jmmarino2/spinnaker/img/spinnaker_block_diagram.png

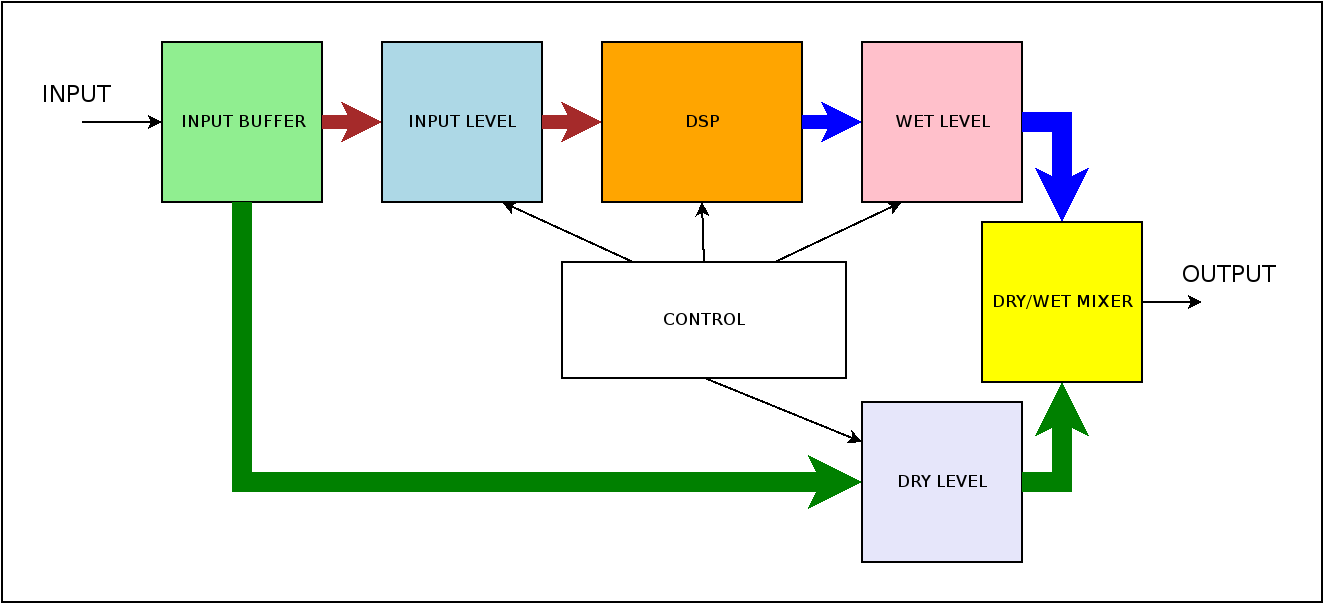
img/spinnaker_block_diagram.png
