jmmarino2/spinnaker/schematics/spinnaker_kicad/spinnaker.kicad_pcb

## KiCad design schematics/spinnaker_kicad/spinnaker.kicad_pcb (2025-03-15)

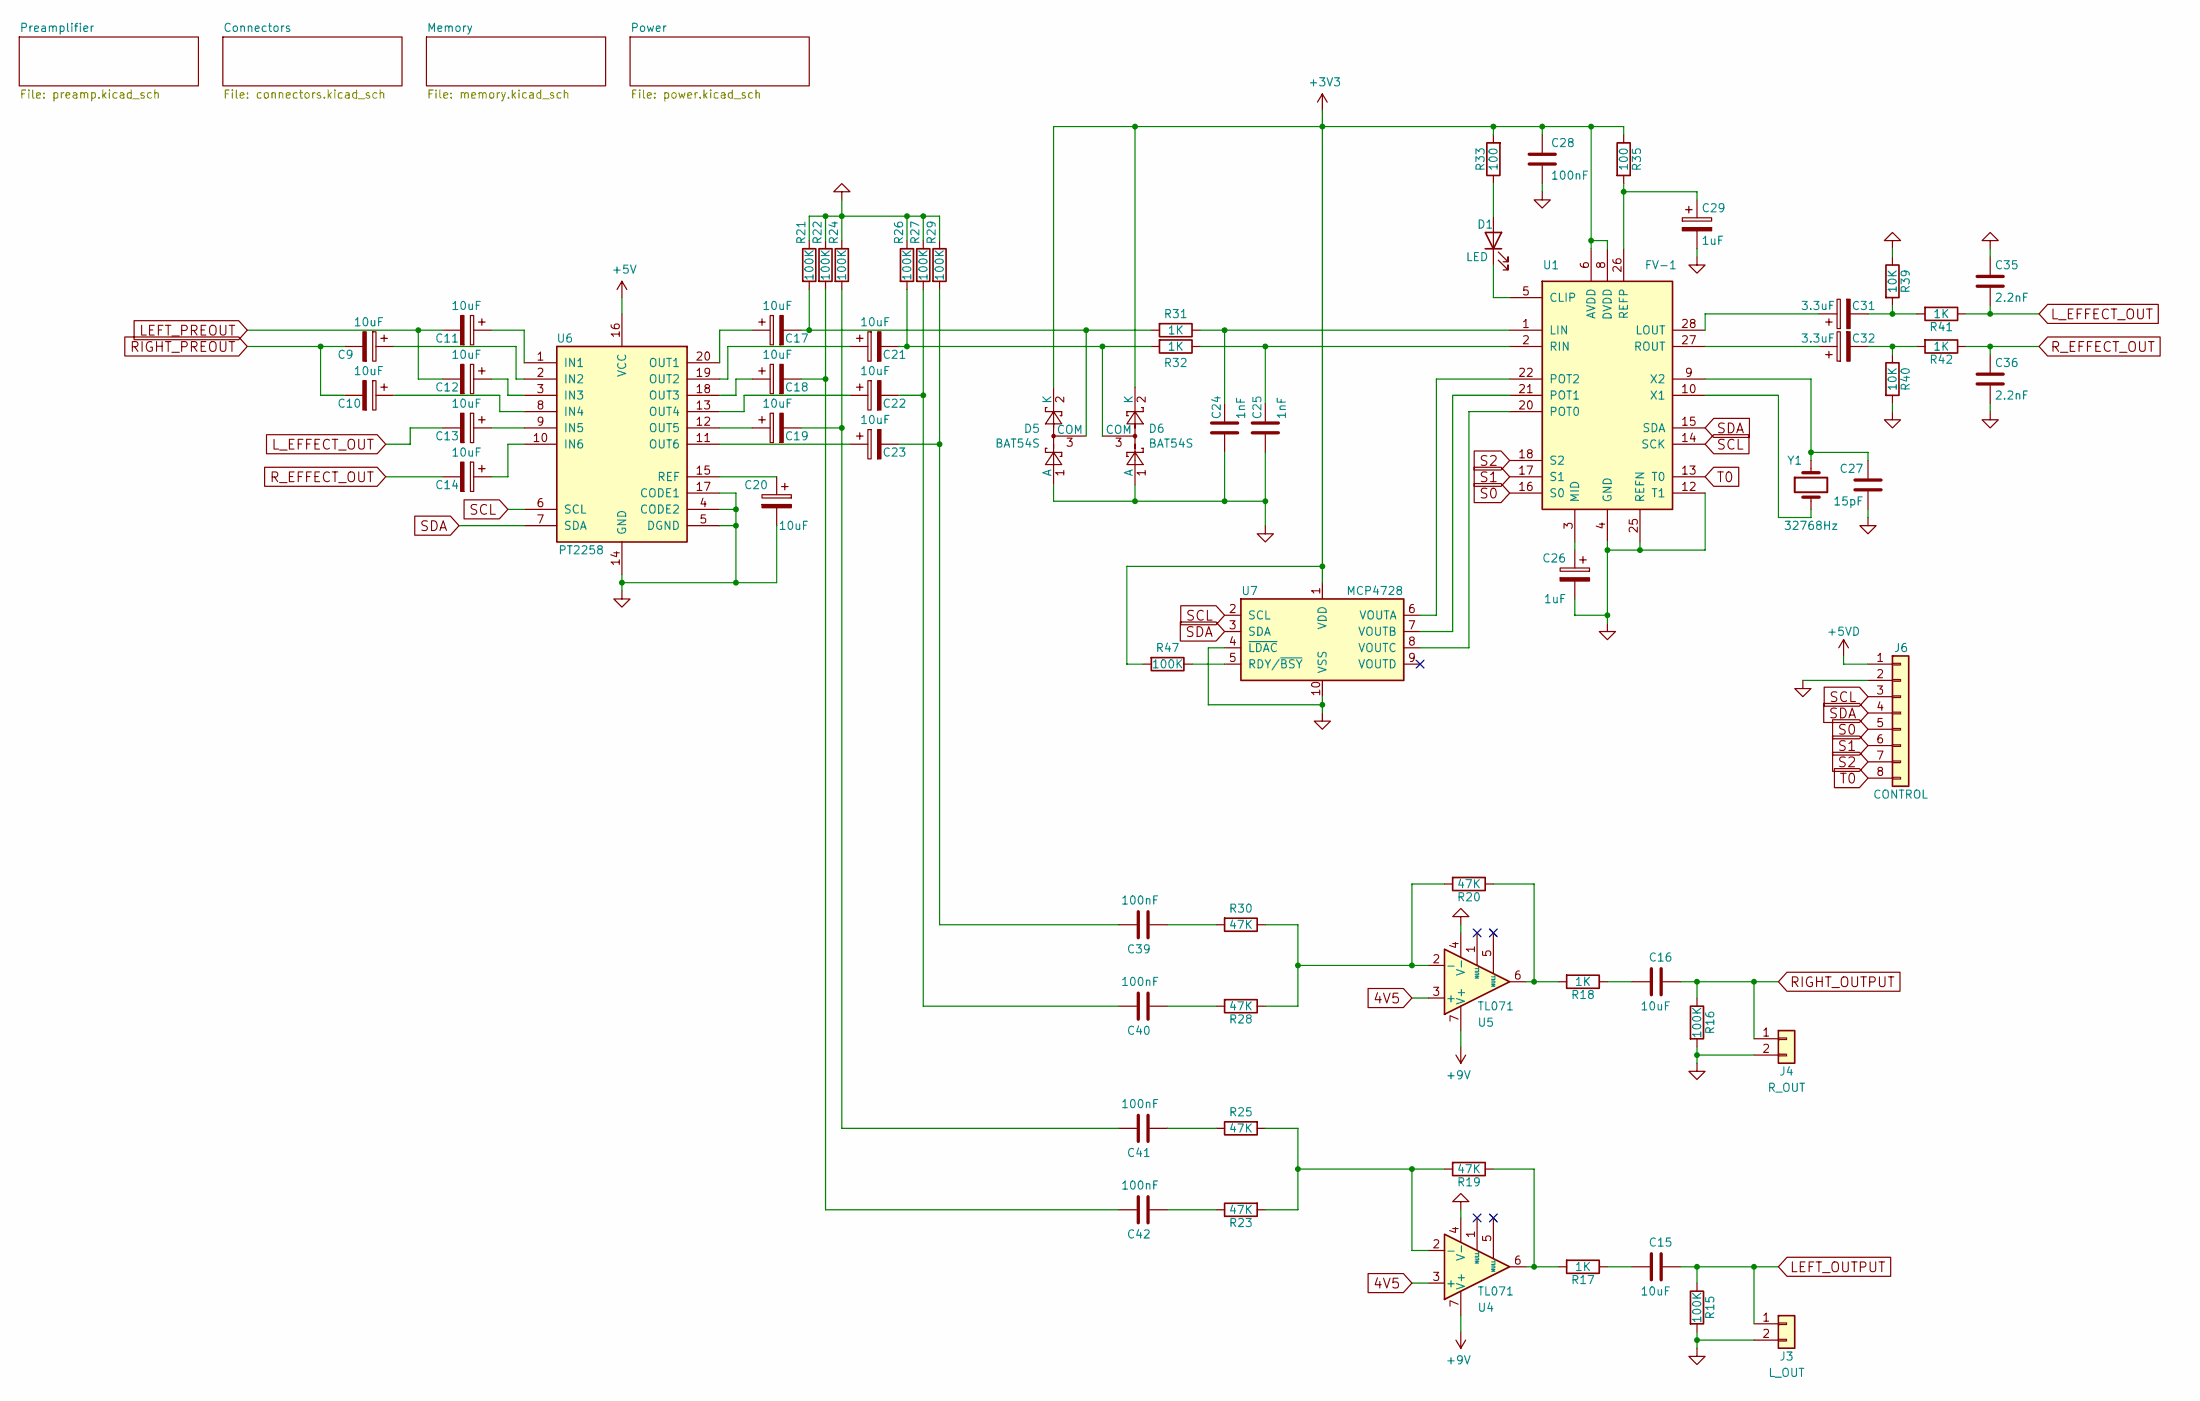
[picture p2: schematic spinnaker.kicad_sch]

Parts:
C9, C10, C11, C12, C13, C14, C15, C16, C17, C18, C19, C20, C21, C22, C23: 10uF; C_0805_2012Metric
C24, C25: 1nF; C_0805_2012Metric
C26, C29: 1uF; C_0805_2012Metric
C27: 15pF; C_0805_2012Metric
C28, C39, C40, C41, C42: 100nF; C_0805_2012Metric
C31, C32: 3.3uF; C_0805_2012Metric
C35, C36: 2.2nF; C_0805_2012Metric
D1: LED; SolderWire-0.75sqmm_1x02_P4.8mm_D1.25mm_OD2.3mm
D5, D6: BAT54S; SOT-23
J3: L_OUT; SolderWire-0.75sqmm_1x02_P4.8mm_D1.25mm_OD2.3mm
J4: R_OUT; SolderWire-0.75sqmm_1x02_P4.8mm_D1.25mm_OD2.3mm
J6: CONTROL; JST_PH_B8B-PH-K_1x08_P2.00mm_Vertical
R15, R16, R21, R22, R24, R26, R27, R29, R47: 100K; R_0805_2012Metric
R17, R18, R31, R32, R41, R42: 1K; R_0805_2012Metric
R19, R20, R23, R25, R28, R30: 47K; R_0805_2012Metric
R33, R35: 100; R_0805_2012Metric
R39, R40: 10K; R_0805_2012Metric
U1: FV-1; SOIC-28W_7.5x17.9mm_P1.27mm
U4, U5: TL071; SOIC-8_3.9x4.9mm_P1.27mm
U6: PT2258; SO-20_12.8x7.5mm_P1.27mm
U7: MCP4728; MSOP-10_3x3mm_P0.5mm
Y1: 32768Hz; Crystal_SMD_3215-2Pin_3.2x1.5mm

Connections:
4V5: U4.3 (+), U5.3 (+); also elsewhere on the board
+5V: U6.16 (VCC); also elsewhere on the board
+5VD: J6.1; also elsewhere on the board
+9V: U4.7 (V+), U5.7 (V+); also elsewhere on the board
Earth: C20.2, C24.2, C25.2, C26.2, C27.2, C28.1, C29.2, C35.1, C36.2, D5.1 (A), D6.1 (A), J3.2, J4.2, J6.2, R15.2, R16.2, R21.1, R22.1, R24.1, R26.1, R27.1, R29.1, R39.1, R40.2, U1.4 (GND), U1.7 (GND), U1.11 (GND), U1.12 (T1), U1.19 (GND), U1.24 (GND), U1.25 (REFN), U4.4 (V-), U5.4 (V-), U6.4 (CODE2), U6.5 (DGND), U6.14 (GND), U6.17 (CODE1), U7.4 (~LDAC), U7.10 (VSS); also elsewhere on the board
LEFT_OUTPUT: C15.1, J3.1, R15.1
LEFT_PREOUT: C11.2, C12.2; also elsewhere on the board
L_EFFECT_OUT: C13.2, C35.2, R41.1
unnamed: C9.1, U6.2 (IN2)
unnamed: C10.1, U6.8 (IN4)
unnamed: C11.1, U6.1 (IN1)
unnamed: C12.1, U6.3 (IN3)
unnamed: C13.1, U6.9 (IN5)
unnamed: C14.1, U6.10 (IN6)
unnamed: C15.2, R17.1
unnamed: C16.2, R18.1
unnamed: C17.1, U6.20 (OUT1)
unnamed: C17.2, D5.3 (COM), R21.2, R31.2
unnamed: C18.1, U6.18 (OUT3)
unnamed: C18.2, C42.1, R22.2
unnamed: C19.1, U6.12 (OUT5)
unnamed: C19.2, C41.1, R24.2
unnamed: C20.1, U6.15 (REF)
unnamed: C21.1, U6.19 (OUT2)
unnamed: C21.2, D6.3 (COM), R26.2, R32.2
unnamed: C22.1, U6.13 (OUT4)
unnamed: C22.2, C40.1, R27.2
unnamed: C23.1, U6.11 (OUT6)
unnamed: C23.2, C39.1, R29.2
unnamed: C24.1, R31.1, U1.1 (LIN)
unnamed: C25.1, R32.1, U1.2 (RIN)
unnamed: C26.1, U1.3 (MID)
unnamed: C27.1, U1.9 (X2), Y1.1
unnamed: C29.1, R35.2, U1.26 (REFP)
unnamed: C31.1, U1.28 (LOUT)
unnamed: C31.2, R39.2, R41.2
unnamed: C32.1, U1.27 (ROUT)
unnamed: C32.2, R40.1, R42.2
unnamed: C39.2, R30.2
unnamed: C40.2, R28.2
unnamed: C41.2, R25.1
unnamed: C42.2, R23.1
unnamed: D1.1 (K), U1.5 (CLIP)
unnamed: D1.2 (A), R33.1
unnamed: R17.2, R19.1, U4.6
unnamed: R18.2, R20.1, U5.6
unnamed: R19.2, R23.2, R25.2, U4.2 (-)
unnamed: R20.2, R28.1, R30.1, U5.2 (-)
unnamed: U1.10 (X1), Y1.2
unnamed: U1.20 (POT0), U7.8 (VOUTC)
unnamed: U1.21 (POT1), U7.7 (VOUTB)
unnamed: U1.22 (POT2), U7.6 (VOUTA)
RIGHT_OUTPUT: C16.1, J4.1, R16.1
RIGHT_PREOUT: C9.2, C10.2; also elsewhere on the board
R_EFFECT_OUT: C14.2, C36.1, R42.1
S0: J6.5, U1.16 (S0)
S1: J6.6, U1.17 (S1)
S2: J6.7, U1.18 (S2)
SCL: J6.3, U1.14 (SCK), U6.6 (SCL), U7.2 (SCL); also elsewhere on the board
SDA: J6.4, U1.15 (SDA), U6.7 (SDA), U7.3 (SDA); also elsewhere on the board
T0: J6.8, U1.13 (T0)

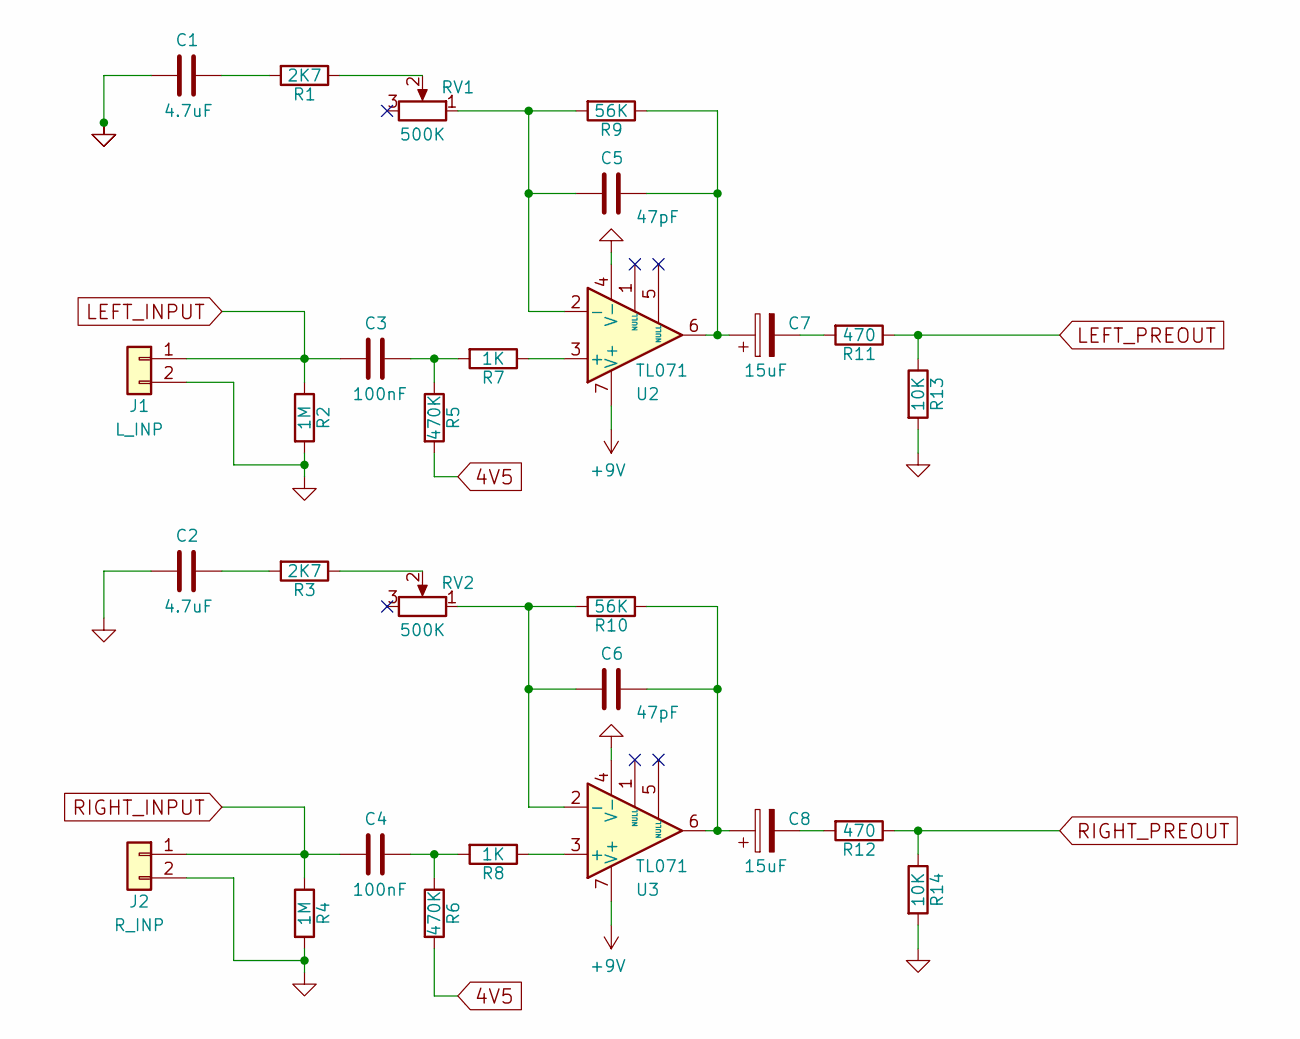
[picture p3: schematic preamp.kicad_sch]

Parts:
C1, C2: 4.7uF; C_0805_2012Metric
C3, C4: 100nF; C_0805_2012Metric
C5, C6: 47pF; C_0805_2012Metric
C7, C8: 15uF; C_0805_2012Metric
J1: L_INP; SolderWire-0.75sqmm_1x02_P4.8mm_D1.25mm_OD2.3mm
J2: R_INP; SolderWire-0.75sqmm_1x02_P4.8mm_D1.25mm_OD2.3mm
R1, R3: 2K7; R_0805_2012Metric
R2, R4: 1M; R_0805_2012Metric
R5, R6: 470K; R_0805_2012Metric
R7, R8: 1K; R_0805_2012Metric
R9, R10: 56K; R_0805_2012Metric
R11, R12: 470; R_0805_2012Metric
R13, R14: 10K; R_0805_2012Metric
RV1, RV2: 500K; SolderWire-0.75sqmm_1x02_P4.8mm_D1.25mm_OD2.3mm
U2, U3: TL071; SOIC-8_3.9x4.9mm_P1.27mm

Connections:
4V5: R5.2, R6.2; also elsewhere on the board
+9V: U2.7 (V+), U3.7 (V+); also elsewhere on the board
Earth: C1.2, C2.2, J1.2, J2.2, R2.2, R4.2, R13.2, R14.2, U2.4 (V-), U3.4 (V-); also elsewhere on the board
LEFT_INPUT: C3.2, J1.1, R2.1
LEFT_PREOUT: R11.1, R13.1; also elsewhere on the board
unnamed: C1.1, R1.2
unnamed: C2.1, R3.2
unnamed: C3.1, R5.1, R7.2
unnamed: C4.1, R6.1, R8.2
unnamed: C5.1, C7.1, R9.1, U2.6
unnamed: C5.2, R9.2, RV1.1, U2.2 (-)
unnamed: C6.1, C8.1, R10.1, U3.6
unnamed: C6.2, R10.2, RV2.1, U3.2 (-)
unnamed: C7.2, R11.2
unnamed: C8.2, R12.2
unnamed: R1.1, RV1.2
unnamed: R3.1, RV2.2
unnamed: R7.1, U2.3 (+)
unnamed: R8.1, U3.3 (+)
RIGHT_INPUT: C4.2, J2.1, R4.1
RIGHT_PREOUT: R12.1, R14.1; also elsewhere on the board

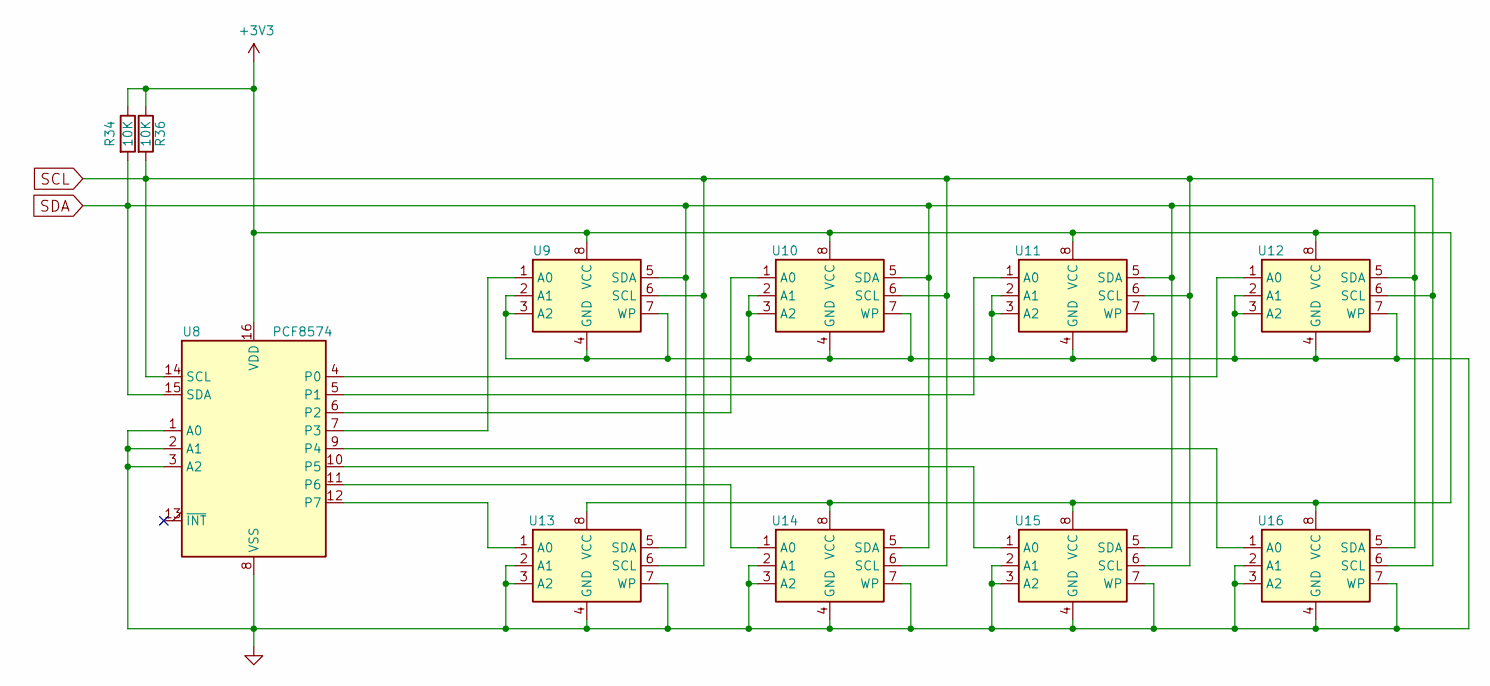
[picture p4: schematic memory.kicad_sch]

Parts:
R34, R36: 10K; R_0805_2012Metric
U8: PCF8574; SOIC-16_3.9x9.9mm_P1.27mm
U9, U10, U11, U12, U13, U14, U15, U16: 24LC32; SOIC-8_3.9x4.9mm_P1.27mm

Connections:
Earth: U8.1 (A0), U8.2 (A1), U8.3 (A2), U8.8 (VSS), U9.2 (A1), U9.3 (A2), U9.4 (GND), U9.7 (WP), U10.2 (A1), U10.3 (A2), U10.4 (GND), U10.7 (WP), U11.2 (A1), U11.3 (A2), U11.4 (GND), U11.7 (WP), U12.2 (A1), U12.3 (A2), U12.4 (GND), U12.7 (WP), U13.2 (A1), U13.3 (A2), U13.4 (GND), U13.7 (WP), U14.2 (A1), U14.3 (A2), U14.4 (GND), U14.7 (WP), U15.2 (A1), U15.3 (A2), U15.4 (GND), U15.7 (WP), U16.2 (A1), U16.3 (A2), U16.4 (GND), U16.7 (WP); also elsewhere on the board
unnamed: U8.7 (P3), U9.1 (A0)
unnamed: U8.6 (P2), U10.1 (A0)
unnamed: U8.5 (P1), U11.1 (A0)
unnamed: U8.4 (P0), U12.1 (A0)
unnamed: U8.12 (P7), U13.1 (A0)
unnamed: U8.11 (P6), U14.1 (A0)
unnamed: U8.10 (P5), U15.1 (A0)
unnamed: U8.9 (P4), U16.1 (A0)
SCL: R36.2, U8.14 (SCL), U9.6 (SCL), U10.6 (SCL), U11.6 (SCL), U12.6 (SCL), U13.6 (SCL), U14.6 (SCL), U15.6 (SCL), U16.6 (SCL); also elsewhere on the board
SDA: R34.2, U8.15 (SDA), U9.5 (SDA), U10.5 (SDA), U11.5 (SDA), U12.5 (SDA), U13.5 (SDA), U14.5 (SDA), U15.5 (SDA), U16.5 (SDA); also elsewhere on the board

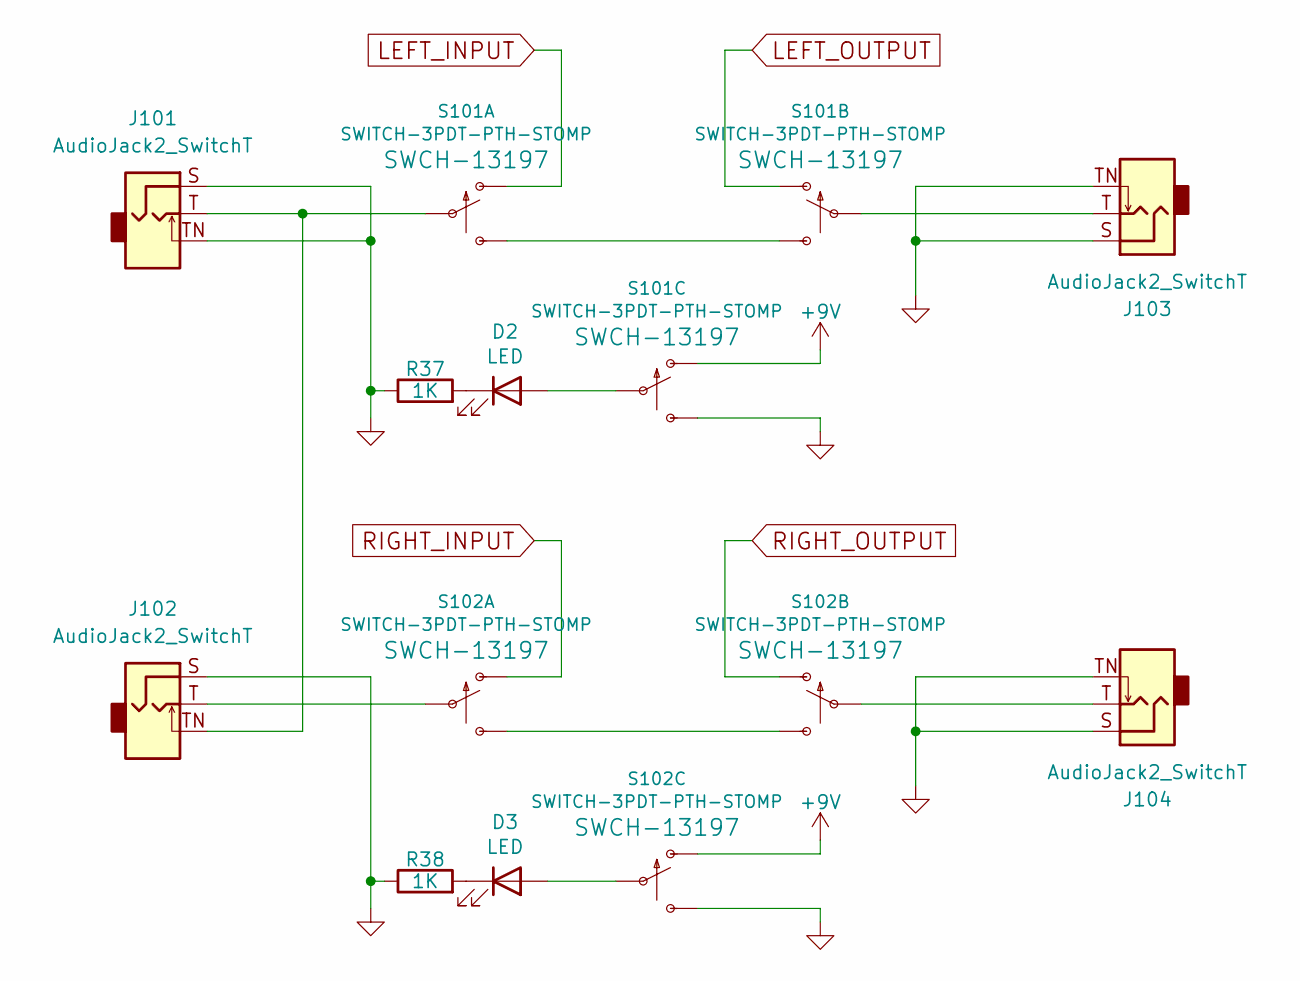
[picture p5: schematic connectors.kicad_sch]

Parts:
D2, D3: LED; SolderWire-0.75sqmm_1x02_P4.8mm_D1.25mm_OD2.3mm
J101, J102, J103, J104: AudioJack2_SwitchT
R37, R38: 1K; R_Axial_DIN0204_L3.6mm_D1.6mm_P5.08mm_Horizontal
S101, S102: SWITCH-3PDT-PTH-STOMP; STOMP_SWITCH_3PDT

Connections:
unnamed: D2.1 (K), R37.2
unnamed: D2.2 (A), S101.P$8
unnamed: D3.1 (K), R38.2
unnamed: D3.2 (A), S102.P$8
unnamed: J101.S, J101.TN, J102.S, J103.S, J103.TN, J104.S, J104.TN, R37.1, R38.1, S101.P$9 (S), S102.P$9 (S)
unnamed: J101.T, J102.TN, S101.P$2
unnamed: J102.T, S102.P$2
unnamed: J103.T, S101.P$5
unnamed: J104.T, S102.P$5
unnamed: S101.P$3 (S), S101.P$6 (S)
unnamed: S101.P$7 (O), S102.P$7 (O)
unnamed: S102.P$3 (S), S102.P$6 (S)

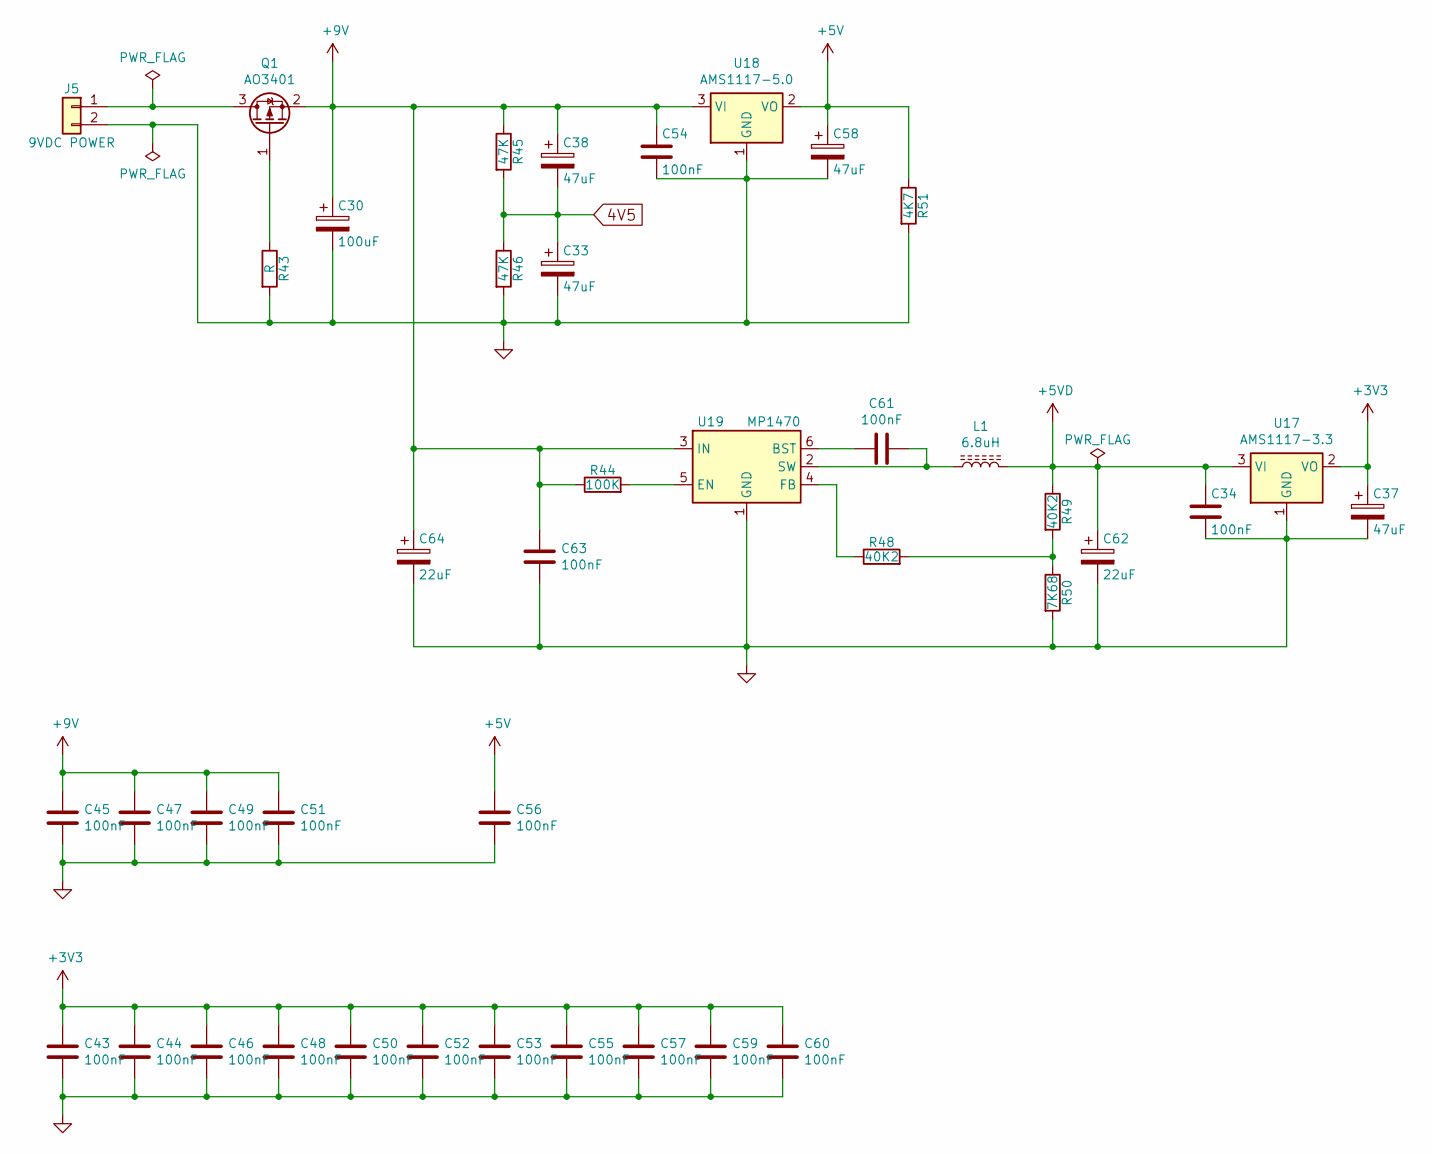
[picture p6: schematic power.kicad_sch]

Parts:
C30: 100uF; CP_EIA-7343-31_Kemet-D
C33, C37, C38, C58: 47uF; C_0805_2012Metric
C34, C43, C44, C45, C46, C47, C48, C49, C50, C51, C52, C53, C54, C55, C56, C57, C59, C60, C61, C63: 100nF; C_0805_2012Metric
C62, C64: 22uF; C_0805_2012Metric
J5: 9VDC POWER; JST_PH_B2B-PH-K_1x02_P2.00mm_Vertical
L1: 6.8uH; L_10.4x10.4_H4.8
Q1: AO3401; SOT-23
R43: R; R_0805_2012Metric
R44: 100K; R_0805_2012Metric
R45, R46: 47K; R_0805_2012Metric
R48, R49: 40K2; R_0805_2012Metric
R50: 7K68; R_0805_2012Metric
R51: 4K7; R_0805_2012Metric
U17: AMS1117-3.3; SOT-223-3_TabPin2
U18: AMS1117-5.0; SOT-223-3_TabPin2
U19: MP1470; TSOT-23-6

Connections:
4V5: C33.1, C38.2, R45.2, R46.1; also elsewhere on the board
+5V: C56.1, C58.1, R51.1, U18.2 (VO); also elsewhere on the board
+5VD: C34.1, C62.1, L1.2, R49.1, U17.3 (VI); also elsewhere on the board
+9V: C30.1, C38.1, C45.1, C47.1, C49.1, C51.1, C54.1, C63.1, C64.1, Q1.2 (S), R44.1, R45.1, U18.3 (VI), U19.3 (IN); also elsewhere on the board
Earth: C30.2, C33.2, C34.2, C37.2, C43.2, C44.2, C45.2, C46.2, C47.2, C48.2, C49.2, C50.2, C51.2, C52.2, C53.2, C54.2, C55.2, C56.2, C57.2, C58.2, C59.2, C60.2, C62.2, C63.2, C64.2, J5.2, R43.2, R46.2, R50.2, R51.2, U17.1 (GND), U18.1 (GND), U19.1 (GND); also elsewhere on the board
unnamed: C61.1, U19.6 (BST)
unnamed: C61.2, L1.1, U19.2 (SW)
unnamed: J5.1, Q1.3 (D)
unnamed: Q1.1 (G), R43.1
unnamed: R44.2, U19.5 (EN)
unnamed: R48.1, U19.4 (FB)
unnamed: R48.2, R49.2, R50.1

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
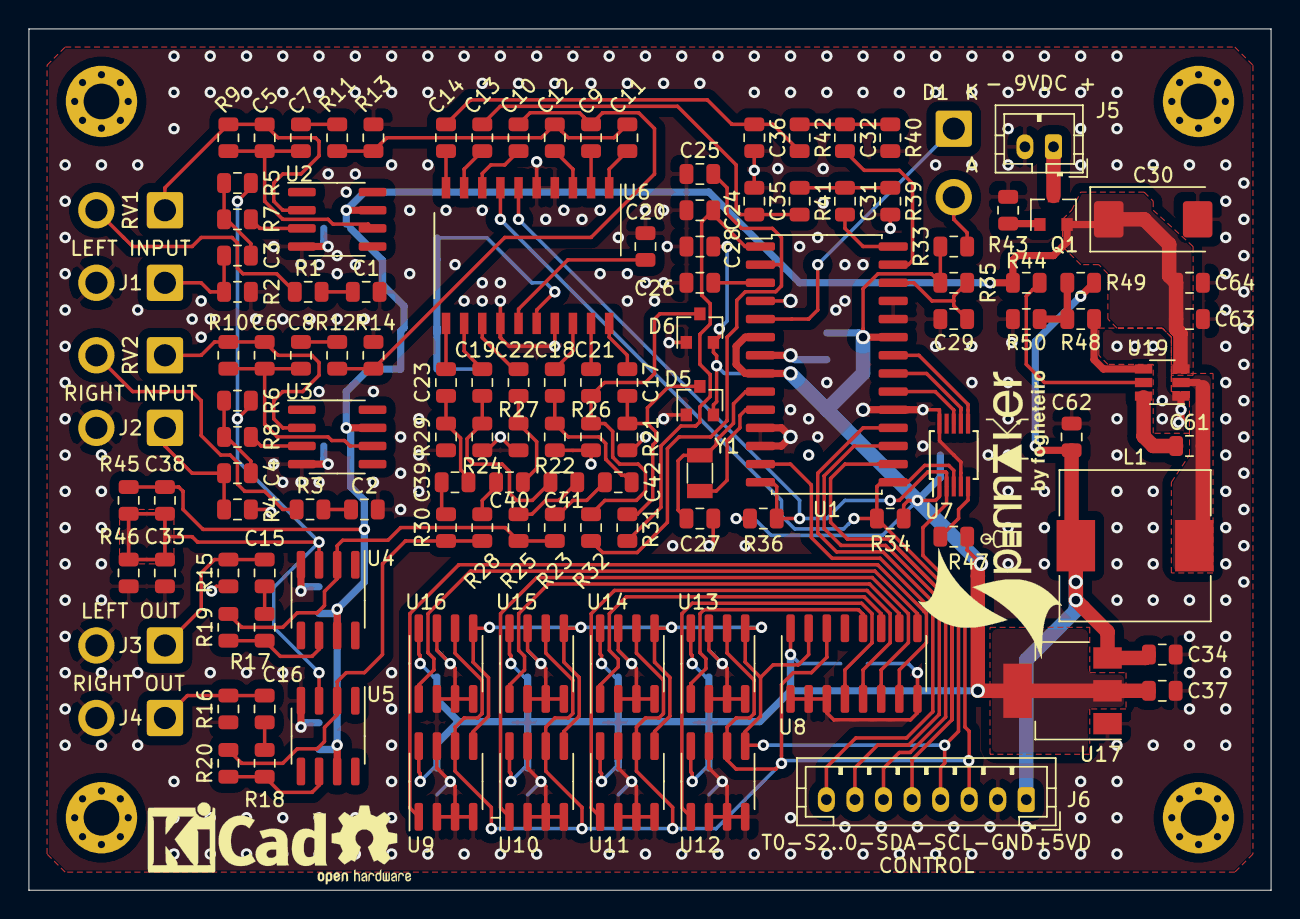
[picture p7: board spinnaker.kicad_pcb from above]

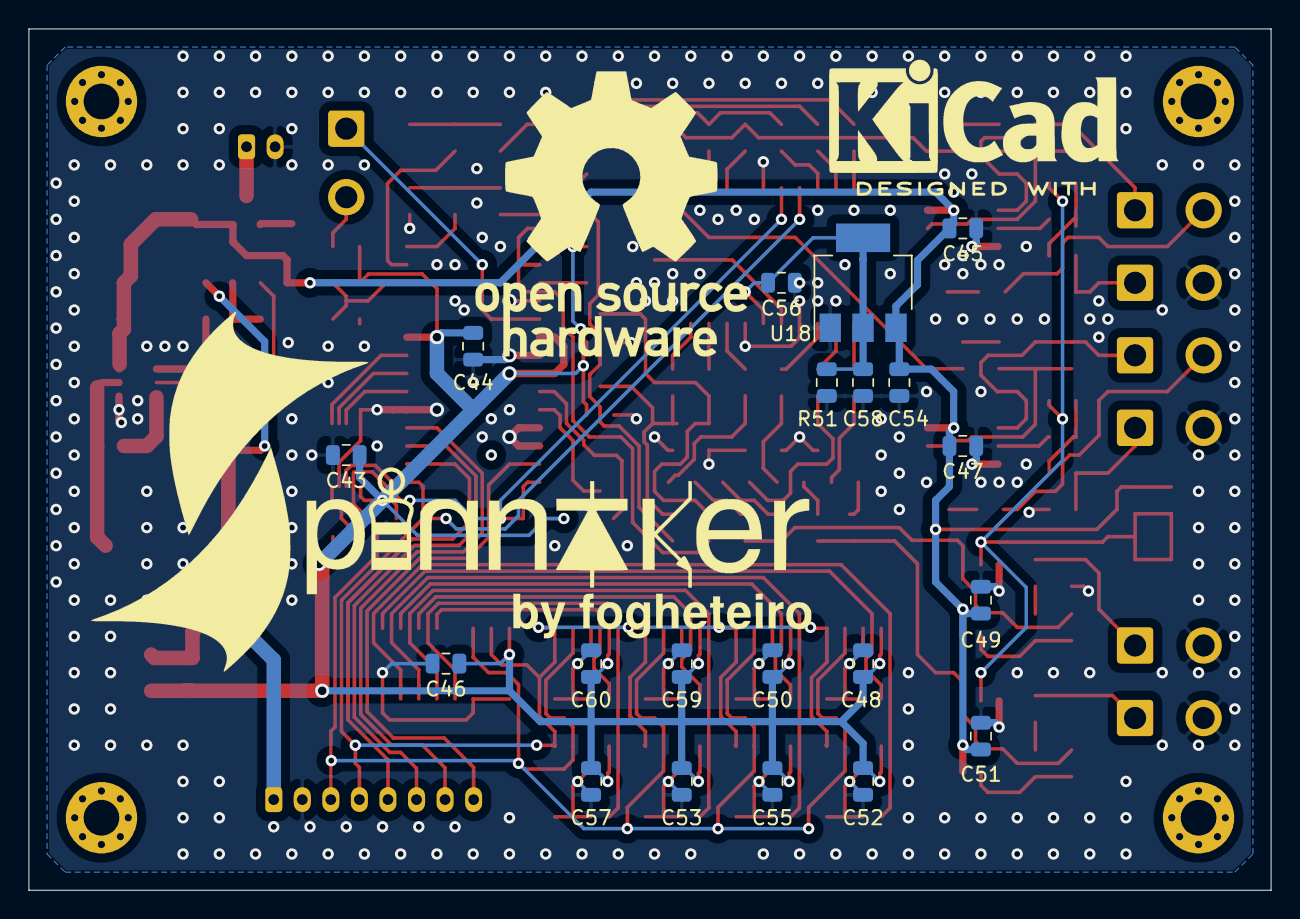
[picture p8: board spinnaker.kicad_pcb from below]

Board: 2 copper layers, 87.0 x 60.3 mm, 146 parts (20 on the bottom side), 94 nets.
