jmmarino2/spinnaker/(threads)

Thread 11 (2020-08-14):

¿ R13/R14 deberían ir a la masa virtual en lugar de al negativo para reducir DC Bias en C7/C8 ?

jmmarino2, 2020-08-14:

jmmarino2, 2020-08-14:
Hay que revisar el efecto que tendría en los condensadores de entrada del PT2258, porque el terminal de la izquierda dejaría de ir a masa y pasaría a estar a un potencial de 4.5V, con lo que supone que cambiaría el sentido de la polarización (no sabemos internamente a qué potencial están las entradas del PT2258). En principio debido a la diferencia en las tensiones de trabajo entre los operacionales y el PT2258, no parece muy adecuado que R13/R14 vayan a la masa virtual, así que casi mejor dejarlo así.

jmmarino2, 2020-08-17:
Reabrimos este punto para repensar de nuevo cómo vamos a realizar el acoplo de todas las secciones.
En principio cada sección (previo, regulador de volumen, DSP, buffer) contaba con sus condensadores de acoplo y resistencias a masa. Sin embargo, parece algo redundante realizar el acoplo en dos fases: por un lado eliminamos la componente DC de una etapa con un condensador, y por otro entramos a siguiente entrada con otro condensador.
Es necesario comprobar qué tal se comporta el circuito eliminando los condensadores redundantes y quedándonos solo con un único condensador entre etapas, eliminando de paso todas las resistencias.

Con esto conseguimos también reducir el efecto negativo del DC Bias sobre los condensadores cerámicos, porque ahora ya no se trata de bloquear toda la componente DC de una etapa, sino solamente la diferencia entre la componente DC de una etapa y la componente DC de la siguiente.

En la conexión entre el previo y el regulador de volumen, por ejemplo, estaríamos hablando de tener un condensador con una DC Bias de 4.5 V y otro con una DC Bias de 2.5 V (se supone que el PT2258 se polarizará más o menos a la mitad de la tensión de funcionamiento). Si simplificamos el acople, tendríamos un único condensador que soportaría una DC Bias de 2 V.

Thread 13 (2020-08-14):

Añadir condensador cerámico 100nF en entrada del MP1471A.

jmmarino2, 2020-08-14:
Aunque tenemos un C de tántalo a la entrada, el fabricante recomienda poner un cerámico de 100nF con baja ESR en paralelo.

jmmarino2, 2020-08-17:
Esto ya estaba previsto. C63 es el condensador cerámico de 100nF que recomienda el fabricante.

Closed 2020-08-17.

Thread 14 (2020-08-14):

Repartir el condensador de salida del MP1471A entre dos o más.

jmmarino2, 2020-08-14:
En los ejemplos del fabricante se usan dos condensadores de 22uF en lugar de uno de 47uF.
Estudiar posibilidad de montar una batería de condensadores de menor capacidad. Esto va relacionado con lo del DC Bias de los MLCC.

Thread 15 (2020-08-15):

Eliminar C64 y sustituir C63 por un condensador con un tamaño más grande.

jmmarino2, 2020-08-15:
La pareja C64 se podría simplificar ya que no tiene sentido tener un electrolítico más al estar en paralelo con C30.
Es necesario revisar si C63 ve reducida su capacidad por el efecto del DC Bias. Si fuese necesario, habría que poner un tamaño más grande de SMD o bien uno de mayor capacidad para compensar la pérdida originada por el DC Bias.

Thread 16 (2020-08-15):

Revisar los pines de los potenciómetros de ganancia en el previo.

jmmarino2, 2020-08-15:
RV1/RV2 tienen que ser potenciómetros Reverse Log. Es necesario revisar la asignación de pines. No es importante para nuestro diseño de PCB porque los potenciómetros irán cableados y por lo tanto no es más que un proceso de prueba y error, pero en caso de que alguien quiera incorporar el potenciómetro en placa tenemos que asegurar que los pines están correctamente numerados.

Thread 17 (2020-08-15):

Añadir indicación de tipo de condensador en C24/C25

jmmarino2, 2020-08-15:
Según la documentación de Spin:

The inputs should be conducted through coupling capacitors, as the inputs are internally biased to a VDD/2 potential. The
input signals should be led through 1K resistances with 1nF capacitors directly to ground as close as possible to the input
pins. These bypass capacitors should be of good quality, either film capacitors or NP0 (COG) ceramic. The purpose of this input bypassing is to remove any high frequency noise from the input signals, and to provide a low impedance at very
high frequencies.

Thread 18 (2020-08-15):

Revisar si hay que añadir condensadores de desacoplo en las entradas del FV-1

jmmarino2, 2020-08-15:
En principio habíamos eliminado los condensadores de desacoplo, porque ya contábamos con los de la salida del PT2258. Sin embargo, está por comprobar si realmente son necesarios. Hay que averiguar si el hecho de tener las resistencias de 100K a masa provoca un cambio en el bias de las entradas del FV-1.

Thread 19 (2020-08-17):

Evaluar posibilidad para añadir resistencia en serie a la entrada de alimentación.

jmmarino2, 2020-08-17:
Si incluimos una resistencia antes del condensador de filtrado, a modo de filtro RC, se podría mejorar el ruido en los operacionales.

Los operacionales van directos a la alimentación de 9V. Para filtrar posibles ruidos de la alimentación se podría añadir una resistencia de bajo valor (para no provocar una caída de tensión excesiva). De esa forma en la resistencia quedaría todo el ruido de alta frecuencia.

El valor de la resistencia tendría que de unos pocos Ohm, no más de 4R7, teniendo en cuenta que el consumo del spinnaker andará sobre 100 mA.

Thread 20 (2020-08-17):

Eliminar R11/R12.

jmmarino2, 2020-08-17:
Las resistencias R11/R12 se planteaban en el diseño del MXR Microamp como protección ante cortocircuitos en la salida.
Dado que estamos utilizando un diseño similar como previo antes del PT2258, podríamos eliminarlas dado que podemos asumir que no habrá cortocircuitos al no estar esas salidas expuestas al exterior.

Thread 22 (2020-08-18):

Modificar previo para que permita un pequeño margen de atenuación.

jmmarino2, 2020-08-18:
El previo de entrada debería permitir no sólo ampliar la señal, sino también un pequeño margen de atenuación. Spinnakef podría recibir una señal de entrada de otro pedal con una salida excesiva, o incluso podría usarse para otras cosas que no sean una guitarra, por lo que conviene que el previo tenga ganancias tanto positivas como negativas (en dB).
