jmmarino2/spinnaker/(commit log)

2018-02-04 Initial load of schematics
    [spinnaker.kicad_pcb, spinnaker.sch]
2018-08-10 Actualización 10/08/2018
    [spinnaker.sch]
2020-06-17 Actualización de diseño y cambio de versión en Kicad
    [connectors.sch, memory.sch, power.sch, preamp.sch, spinnaker-2020-05-30-22-55-42.sch, spinnaker.dsn]
2020-06-21 Rediseño PCB
2020-06-21 Corrección de conexiones no enrutadas
    [connectors.sch, memory.sch, power.sch, preamp.sch, spinnaker.dsn, spinnaker.kicad_pcb, spinnaker.sch]
2020-06-25 Rediseño con SMPS.
    [power.sch, spinnaker.kicad_pcb, spinnaker.sch]
2020-06-25 Cambio de conectores a JST-PH. Reducimos alimentación en conector de control a sólo +5VD (SMPS). Otros retoques menores.
    [power.sch, spinnaker.kicad_pcb, spinnaker.sch]
2020-06-26 Recolocar etiquetas en silkscreen. Añadir logos en silkscreen. Añadir mallado de vías en planos de tierra.
    [power.sch, preamp.sch, spinnaker.kicad_pcb, spinnaker.sch]
2020-06-27 Pequeños retoques en la PCB (espaciado de pistas, zona de 3V3 para disipar calor, etc...)
    [spinnaker.kicad_pcb]
2020-06-28 Se añade logo en silkscreen
    [spinnaker.kicad_pcb]
2020-06-28 Se añaden librerías de huellas con el logo en diferetes tamaños para el silkscreen
2020-06-30 Eliminación de vias sobre pads. Ligeros retoques en la PCB. Arreglamos el lío de librerías debido al cambio de versión de Kicad.
    [connectors.sch, power.sch, preamp.sch, spinnaker-2020-05-30-22-55-42.sch, spinnaker.kicad_pcb, spinnaker.sch]
2020-07-01 Pequeños retoques en zonas de relleno de la PCB y en la silkscreen.
    [spinnaker-B_Cu.gbl, spinnaker-B_Mask.gbs, spinnaker-B_Paste.gbp, spinnaker-B_SilkS.gbo, spinnaker-Edge_Cuts.gm1, spinnaker-F_Cu.gtl, spinnaker-F_Mask.gts, spinnaker-F_Paste.gtp]
2020-08-10 Gerber files, BOM list
    [spinnaker-B_Cu.gbr, spinnaker-B_Mask.gbr, spinnaker-B_Paste.gbp, spinnaker-B_SilkS.gbr, spinnaker-Edge_Cuts.gbr, spinnaker-F_Cu.gbr, spinnaker-F_Mask.gbr, spinnaker-F_Paste.gtp]
2020-08-11 BOM en html
2020-08-11 Modificado tipo de resistencia R37, R38
    [connectors.sch]
2025-03-15 Files upgraded to KICAD_v9.
    [connectors.kicad_sch, memory.kicad_sch, power.kicad_sch, preamp.kicad_sch, spinnaker.kicad_pcb, spinnaker.kicad_sch]
